technolabelectronics/SMT-4-Node-Smart-HomeAutomation-PCB.-ESP32/4Node smt pcb I&M.png

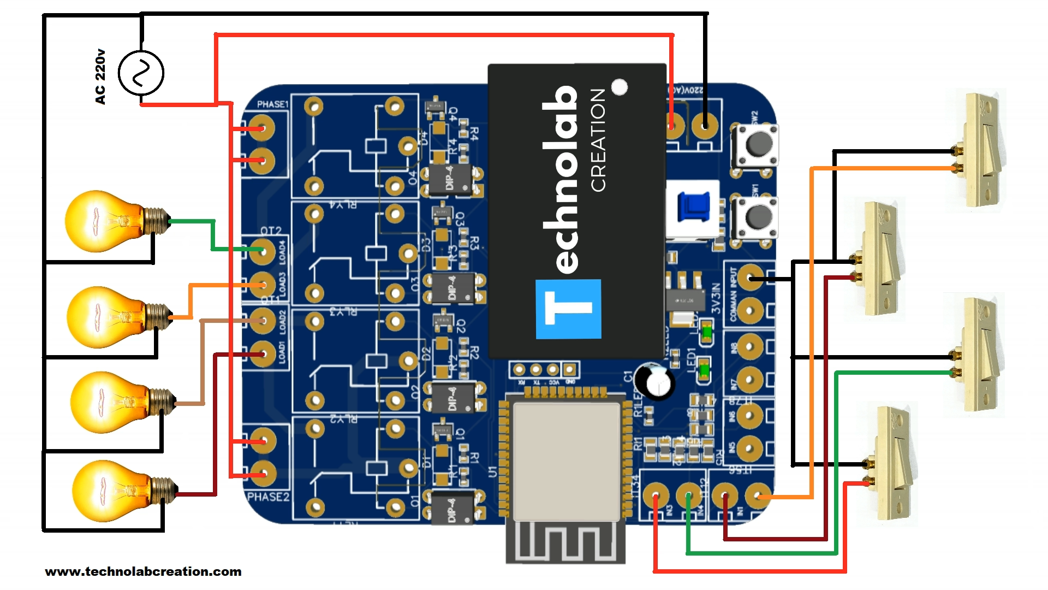
4Node smt pcb I&M.png
