technolabelectronics/SMT-4-Node-Smart-HomeAutomation-PCB.-ESP32/IMG_73hbj16.jpg

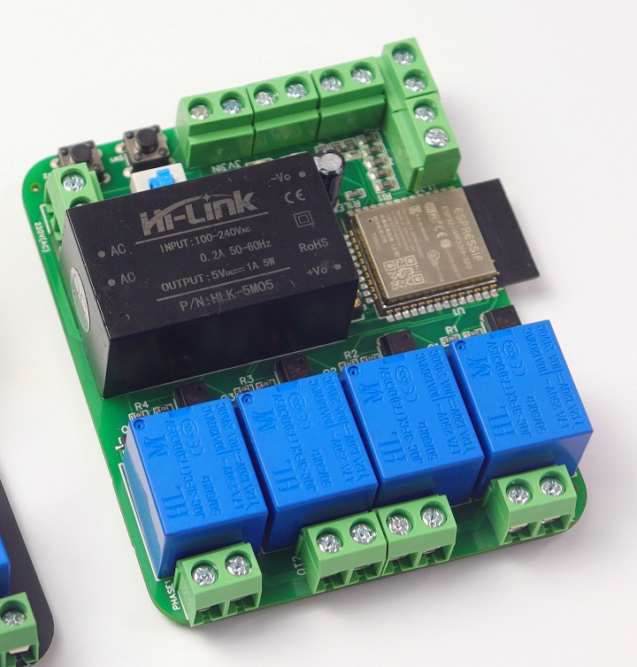
IMG_73hbj16.jpg
