technolabelectronics/SMT-4-Node-Smart-HomeAutomation-PCB.-ESP32/README.md

# SMT-4-Node-Smart-HomeAutomation-PCB.-ESP32

Visit JLCPCB ( https://jlcpcb.com/RNA )

# INTRODUCTION

Hey hello friends welcome to another post, In this article, I am going to introduce my newly design fully SMT components used 4 channel remotely and manually controlled homeAutomation PCB.
I have also made 8 channel SMT homeautomation PCB, TMT Components used homeautomation PCB.
This homeautoamtion PCB is very small in size and compact which can easily fits in your electrical switch boards.
This PCB has inbuilt OTA button, that is, you can update the code wirelessly over the air.
And there is two Onbaord Led’s which you could use according to your need like testing your code or something else.
In my case I have  used as WIFI indicator that is if WIFI connection is available then both the Led’s will glow else only single Led will glow.

By using this PCB, I will make a small homeautomation system that is internet and manual controlled homeautoamtion system using blynk iot plateform.
In this home-automation system we can control our home-appliances by using blynk smartphone application from anywhere in this world

Apart from this we can also control our home-appliances through manual switches that we generally use in our homes and we can also monitor the real-time status in the blynk smartphone application.
This PCB is compatible for all the smart speakers available in the market like Amazons Alexa , google home and Apples SIRI.

If you want to purchase this 8 node SMT homeautomation pcb then connect me. Email- technolabcreationindia@gmail.com

# Ordering the PCBs at jlcpcb.
This project is sponsored by jlcpcb. jlcpcb is a full feature Printed Circuit Board manufacturing service.

Turn your DIY breadboard circuits into professional PCBs – get 10 boards for approximately $5 + shipping (which will vary depending on your country).

Once you have your Gerber files, you can order the PCB. Follow the next steps.

1.Download the Gerber files – click here to download the .zip file

2.Go to https://jlcpcb.com/RNA website and Click on Quote Now button.

3.Upload the gerber file you downloaded in the last step. Upload the.zip file or you can also drag and drop the gerber files.

After uploading the zip file, you’ll see a success message at the bottom if the file is successfully uploaded. You can review the PCB in the Gerber viewer to make sure everything is good. jlcpcb can grab all the PCB details and automatically fills them for you.

# Download link for Gerber file, Schematic and apk file for app.
https://www.technolabcreation.com/smt-4-node-smart-homeautomation-pcb-esp32/

# Video tutorial.
https://youtu.be/hoqnzZ2rSrg
