technolabelectronics/SMT-4-Node-Smart-HomeAutomation-PCB.-ESP32/4node smt code flashing circuit.png

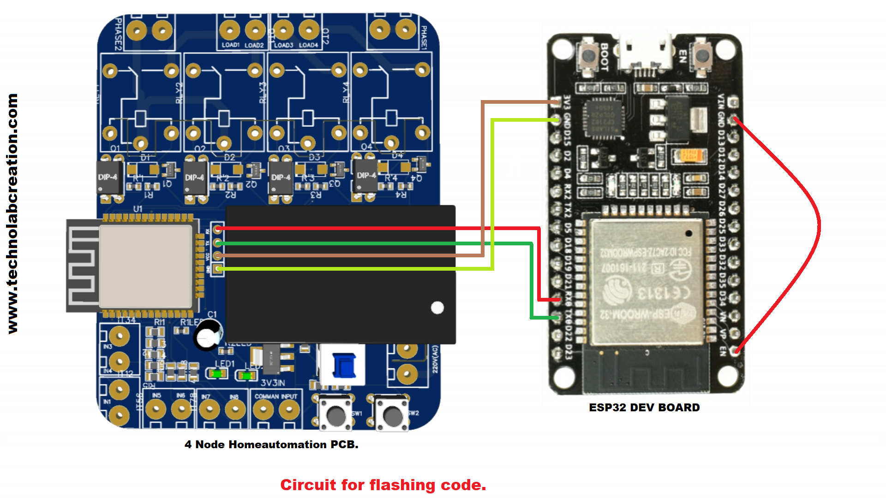
4node smt code flashing circuit.png
