technolabelectronics/SMT-4-Node-Smart-HomeAutomation-PCB.-ESP32/73005.jpg

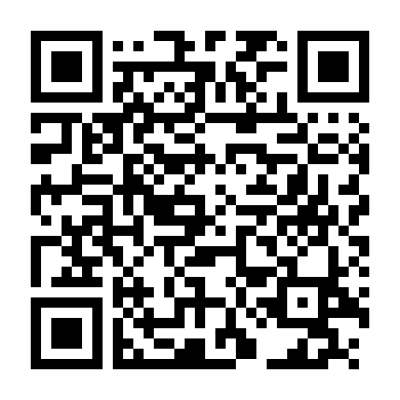
73005.jpg
