technolabelectronics/SMT-4-Node-Smart-HomeAutomation-PCB.-ESP32/Schematic_4 channel homeautomation_2022-02-27.png

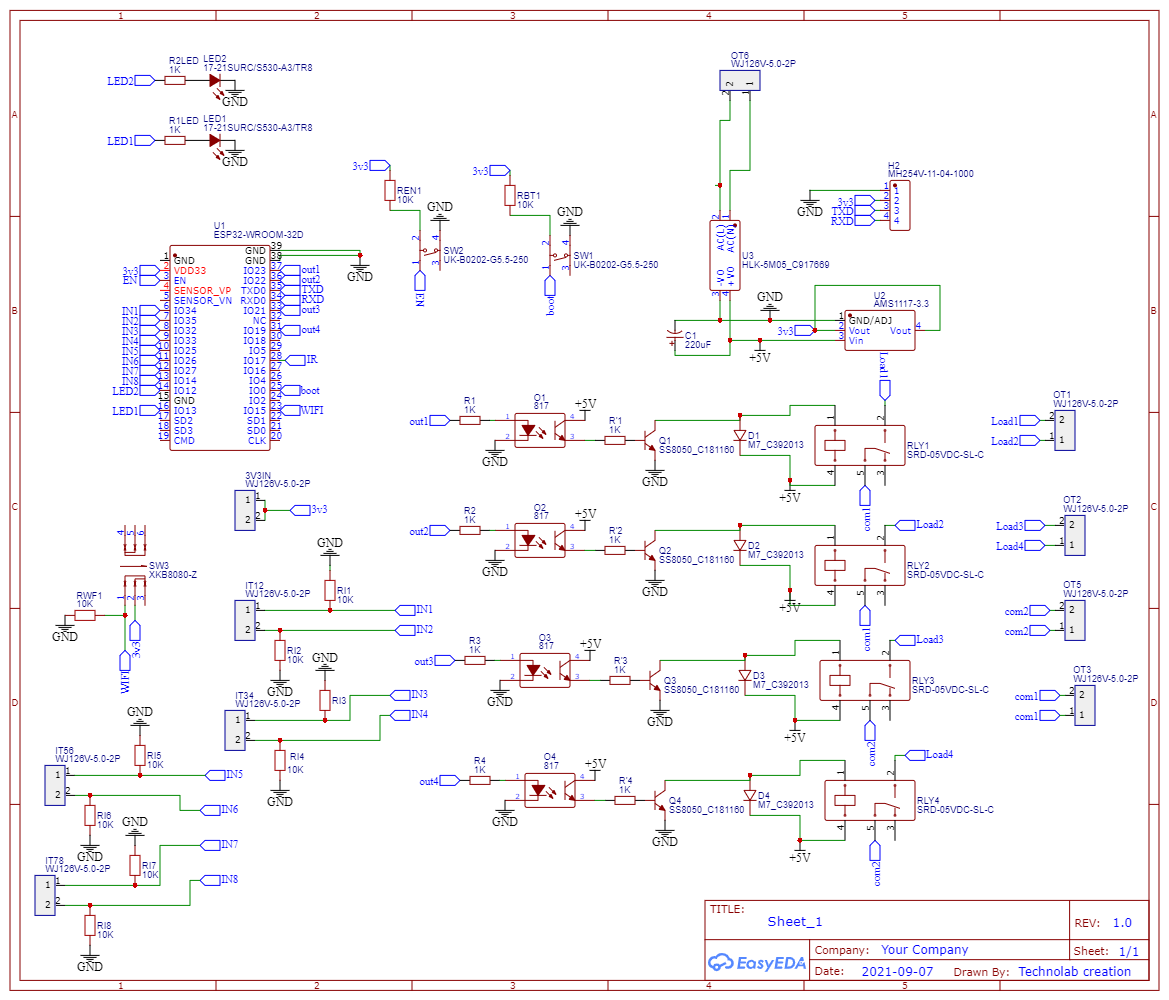
Schematic_4 channel homeautomation_2022-02-27.png
