technolabelectronics/SMT-4-Node-Smart-HomeAutomation-PCB.-ESP32/BOM_PCB_4 channel homeautomation_2022-02-26.csv

ID | Name | Designator | Footprint | Quantity | Manufacturer Part | Manufacturer | Supplier | Supplier Part | Price
1 | WJ126V-5.0-2P | PHASE2,PHASE1,IT56,IT78,3V3IN,IT12,IT34,OT1,OT2,OT6 | PIT_WJ126V-5.0-2P | 10 | WJ126V-5.0-2P | ReliaPro | LCSC | C8404 | 0.074
2 | MH254V-11-04-1000 | RX | HDR-TH_4P-P2.54-V-M-3 | 1 | MH254V-11-04-1000 | XFCN | LCSC | C509261 | 0.101
3 | UK-B0202-G5.5-250 | SW1,SW2 | SW-TH_4P-L6.0-W6.0-P4.50-LS6.5 | 2 | UK-B0202-G5.5-250 | USAKRO | LCSC | C620156 | 0.045
4 | 10K | RBT1,REN1,RI1,RI2,RI3,RI4,RI5,RI6,RI7,RI8,RWF1 | R0805 | 11 | 0805W8F1002T5E | Uniroyal Elec | LCSC | C38522 | 0.003
5 | 220uF | C1 | CAP-TH_BD5.0-P2.00-D0.8-FD | 1 | 220uF 10V 5*11 | ValuePro | LCSC | C43319 | 0.015
6 | M7_C392013 | D1,D2,D3,D4 | SMA_L4.4-W2.6-LS5.0-RD | 4 | M7 | Guangdong Hottech | LCSC | C392013 | 0.013
7 | 17-21SURC/S530-A3/TR8 | LED1,LED2 | LED0805-R-RD | 2 | 17-21SURC/S530-A3/TR8 | EVERLIGHT | LCSC | C72037 | 0.017
8 | 817 | O1,O2,O3,O4 | DIP-4_L4.6-W6.5-P2.54-LS7.6-BL | 4 | UPC817CG-D04-T | UTC | LCSC | C127009 | 0.074
9 | SS8050_C181160 | Q1,Q2,Q3,Q4 | SOT-23-3_L2.9-W1.6-P1.90-LS2.8-BR | 4 | SS8050 | Hottech | LCSC | C181160 | 0.015
10 | 1K | R1,R1LED,R2,R2LED,R3,R4,R'1,R'2,R'3,R'4 | R0603 | 10 | RC0603JR-071KL | YAGEO | LCSC | C14676 | 0.001
11 | SRD-05VDC-SL-C | RLY1,RLY2,RLY3,RLY4 | RELAY-TH_SRD-XXVDC-XL-C | 4 | SRD-05VDC-SL-C | SONGLE | LCSC | C35449 | 0.539
12 | XKB8080-Z | SW3 | SW-TH_6P-L8.0-W8.0-P2.50 | 1 | XKB8080-Z | XKB Enterprise | LCSC | C318860 | 0.134
13 | ESP32-WROOM-32D | U1 | WIFIM-SMD_39P-L25.5-W18.0-P1.27-BL | 1 | ESP32-WROOM-32D | ESPRESSIF 乐鑫 | LCSC | C473012 | 4.339
14 | AMS1117-3.3 | U2 | SOT-223-3_L6.5-W3.4-P2.30-LS7.0-BR | 1 | AMS1117-3.3 | AMS | LCSC | C6186 | 0.164
15 | HLK-5M05_C917669 | U3 | PWRM-TH_HLK-5M12_C917670 | 1 | HLK-5M05 | TESL*A | LCSC | C917669 | 3.144
